KestrelComputer/backbone/(list of files, drawings)

Other design files:
backbone.pcb
