KestrelComputer/backbone/(threads)

Thread 1 (2016-05-28):

96-pin DIN 41612 connector pinouts are missing.

sam-falvo, 2016-05-28:

sam-falvo, 2016-05-29:
Fixed in 477d4e3be44bc4274d351d22a6cfdf349b30456e

Closed 2016-05-29.

Thread 2 (2016-05-30):

96-pin DIN 41612 connector is not easily routed using only 2 layers.

sam-falvo, 2016-05-30:
Maybe consider a 4-layer board, but this easily doubles the price of the backplane.  2 layers is still highly preferable.  So, consider instead the use of two 2x20 box header plugs.

Since this would cause attached cards to lengthen somewhat, put the most useful pins in one connector (J1), and leave the rest for another connector (J2).  Using only J1, I should be able to implement a simple slave peripheral with a minimum of cost: 2 to 4 square inch PCB, plus 8-bit slave-only data path.  With J2, I can also include a 16-bit data path, or access to the entire address space of the bus, or both.  This will require a longer PCB of course; 4 to 8 square inches.

For Kestrel-3, every card will be 16-bit capable, so every card widens to 4 to 8 square inches (up from around 3 to 6 with DIN 41612).  Cheaper connectors make up for the difference though.  Two box headers cost $2/ea. ($4-ish total), versus $7 for *one* DIN 41612 connector.  That just about makes up the price difference (assuming OSH Park pricing for 2 layer PCBs).

    J1: 8-bit Slave Interface
    D0      D1
    D2      GND
    D3      D4
    GND     D5
    D6      D7
    WE      GND
    A1      A2
    GND     A3
    A4      A5
    A6      GND
    A7      A24
    +5V     A25
    A26     A27
    A28     GND
    A29     A30
    GND     A31
    CLK     RESET
    CDONE   GND
    SEL0    ACK
    +5V     STB

    J2: 16-bit Master/Slave Interface Extension
    D8      D9
    D10     GND
    D11     D12
    GND     D13
    D14     D15
    A8      GND
    A9      A10
    GND     A11
    A12     A13
    A14     GND
    A15     A16
    +5V     A17
    A18     A19
    A20     GND
    A21     A22
    GND     A23
    CYC#    CYCA
    BCL#    GND
    SEL1    BGN
    +5V     BGP

sam-falvo, 2016-05-31:
AH HA!  I found out how to tweak my PCB routing tool to let me run traces small enough to route DIN 41612 buses on a single layer!  YEAH!  This issue is obsolete.

Closed 2016-05-31.
