KestrelComputer/backbone/(commit log)

2016-05-28 Provide pinout of connector.
    Also provide pin description, and description of bus mastering
    protocol.
2016-05-29 Add backplane schematics
    [backplane.sch]
2016-05-29 Makefile target for BOM
2016-05-29 Revise schematic based on DRC
    [backplane.sch]
2016-05-29 Forgot clock oscillator
    [backplane.sch]
2016-05-29 WIP: Schematic capture for backplane board.
    I'm grievously upset with the state of affairs for both KiCAD and gEDA
    tools. Neither of them work. At all. Oh, they're great if you're
    making a small board with, say, 10 components and maybe 20 nets or so.
    But go above these simple designs, where you need real, honest to
    goodness mapping of nets to routes, and everything falls apart.
    Existing FOSS tooling is, so far as I've been able to determine, a
    complete joke. Worse than toys, even. At least toys work consistently.
    Beyond a certain complexity to the circuit, gEDA's PCB apparently
    forgets what a "pin" is. No joke.
    I've spent **DAYS** getting to the point where I'm committing this
    patch.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
    [backplane.sch]
2016-05-30 3-part schematic symbol for Backbone.
    1. Addresses PCB's refusal to use symbolic pin names. All pins are now
    *numbered*.
    2. Uses slotting to automatically handle pin numbering.
    Draw row A, B, or C symbol using -1, -2, or -3, respectively. Then use
    slot assignment to automatically renumber the symbol.
    MAYBE this will work. I hope I'm not totally wasting my time.
2016-05-30 Revised for use with box headers
    [backplane-2.sch, backplane.sch]
2016-05-31 A version with box headers instead of DIN41612s.
    [backplane-2.sch, backplane.sch]
2016-05-31 Repair broken pin numbering
2016-05-31 Forgot slot ID
2016-05-31 First attempt at a real PCB
    [backbone.pcb, backplane-2.sch, backplane.sch]
2016-06-02 Add ground plane on back-side of the PCB.
    [backbone.pcb]
2016-06-02 Isolate CDONE and CYC# pins
    [backbone.pcb]
2016-06-03 Added some nice labeling.
    [backbone.pcb]
2016-06-03 Added URLs to project pages
    [backbone.pcb]
2016-06-07 Forgot pull-up resistor on BCL#
    [backbone.pcb, backplane-2.sch]
2016-06-07 Pins for BOURNE footprint
2016-06-11 Change variable resistor symbol
    [backplane.sch]
2016-06-11 Fix pot connectivity.
    However, I've just discovered that all the diodes are backwards too.
    So, gonna hafta fix that now, too. Makes me second-guess the entire
    circuit layout. :(
    [backbone.pcb]
2016-06-11 Fix diode polarity
    [backbone.pcb, backplane.sch]
